DrPacemaker/Voron-Laser-Mod/STLs/laser_pcb_mount.stl

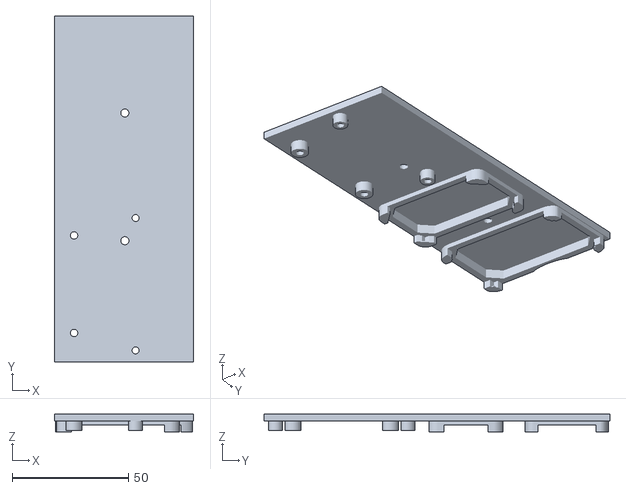
[picture p12: CAD file, 2022-12-12]
STLs/laser_pcb_mount.stl
60.0 x 149.0 x 7.72
