DrPacemaker/Voron-Laser-Mod/STLs/laser_stealthburner_mount.stl

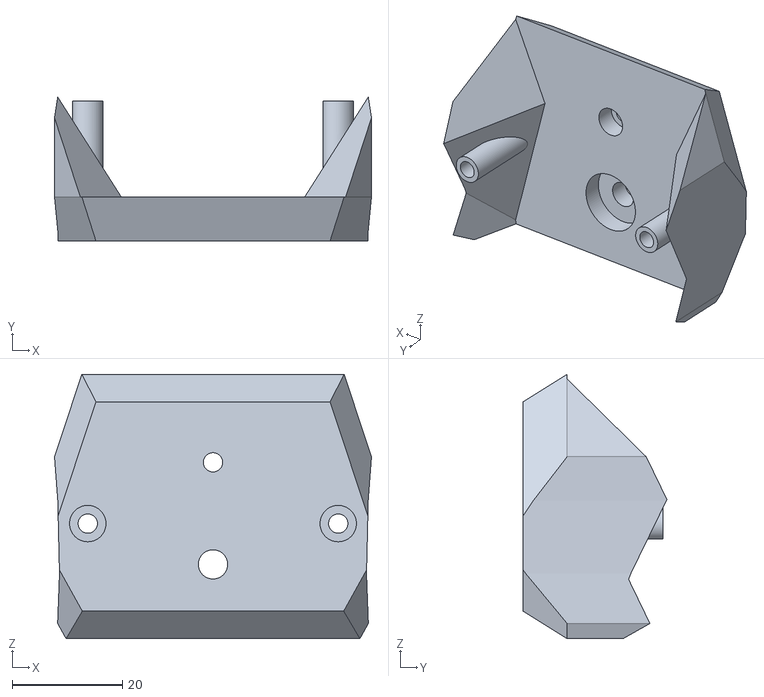
[picture p13: CAD file, 2022-12-12]
STLs/laser_stealthburner_mount.stl
57.5 x 26.1 x 47.9
