DrPacemaker/Voron-Laser-Mod/STLs/laser_air_assist.stl

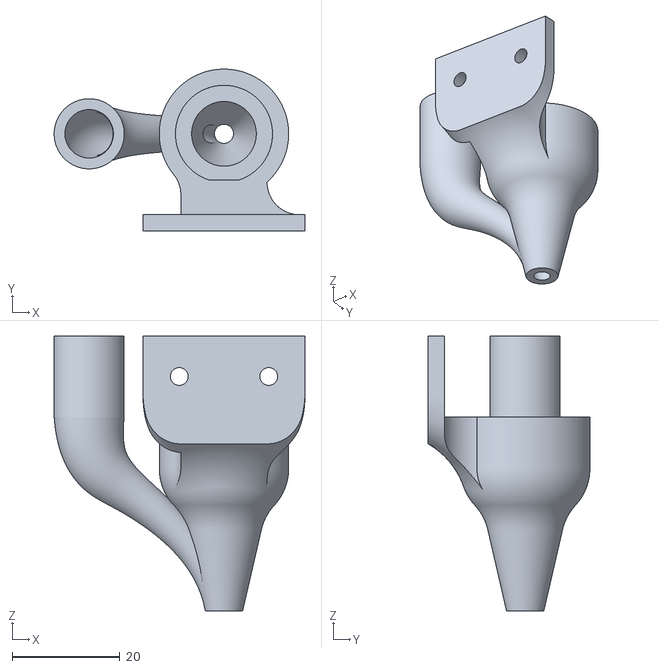
[picture p14: CAD file, 2022-12-12]
STLs/laser_air_assist.stl
46.5 x 30.0 x 51.0
