DrPacemaker/Voron-Laser-Mod/STLs/laser_pcb_bracket.stl

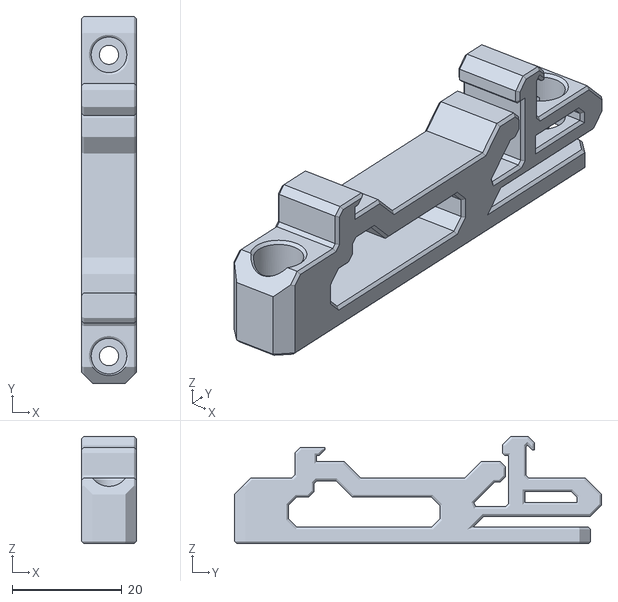
[picture p15: CAD file, 2022-12-12]
STLs/laser_pcb_bracket.stl
10.0 x 67.0 x 19.6
