DrPacemaker/Voron-Laser-Mod/klipper_config/printer.cfg

# This file contains common pin mappings for the BigTreeTech Octopus V1.
# To use this config, the firmware should be compiled for the STM32F446 with a "32KiB bootloader"
# Enable "extra low-level configuration options" and select the "12MHz crystal" as clock reference

# after running "make", copy the generated "klipper/out/klipper.bin" file to a
# file named "firmware.bin" on an SD card and then restart the OctoPus with that SD card.

# See docs/Config_Reference.md for a description of parameters.

## Voron Design VORON2 250/300/350mm BigTreeTech OctoPus V1 TMC2209 UART config

## *** THINGS TO CHANGE/CHECK: ***
## MCU paths                            [mcu] section
## Thermistor types                     [extruder] and [heater_bed] sections - See https://www.klipper3d.org/Config_Reference.html#common-thermistors for common thermistor types
## Z Endstop Switch location            [safe_z_home] section
## Homing end position                  [gcode_macro G32] section
## Z Endstop Switch  offset for Z0      [stepper_z] section
## Probe points                         [quad_gantry_level] section
## Min & Max gantry corner postions     [quad_gantry_level] section
## PID tune                             [extruder] and [heater_bed] sections
## Probe pin                            [probe] section
## Fine tune E steps                    [extruder] section

## Includes
[include ./fluidd.cfg] 
[include ./klicky-probe.cfg] 
[include ./nozzle_scrub.cfg] 
[include ./z_calibration.cfg]    
[include ./laser_boundaries.cfg]    
[include ./chamber_leds.cfg]        
[include ./stealthburner_leds.cfg]  
[include ./runout.cfg] 

[mcu]
##  Obtain definition by "ls -l /dev/serial/by-id/" then unplug to verify
##--------------------------------------------------------------------
serial: /dev/serial/by-id/usb-Klipper_stm32f446xx_130008000250534E4E303720-if00
restart_method: command
##--------------------------------------------------------------------

[printer]
kinematics: corexy
max_velocity: 300  
max_accel: 3000             #Max 4000
max_z_velocity: 15          #Max 15 for 12V TMC Drivers, can increase for 24V
max_z_accel: 350
square_corner_velocity: 5.0

#####################################################################
#   X/Y Stepper Settings
#####################################################################

##  B Stepper - Left
##  Connected to MOTOR_0
##  Endstop connected to DIAG_0
[stepper_x]
step_pin: PF13
dir_pin: PF12
enable_pin: !PF14
rotation_distance: 40
microsteps: 16
full_steps_per_rotation: 200  #set to 400 for 0.9 degree stepper
endstop_pin: PG6
position_min: 0
##--------------------------------------------------------------------

##  Uncomment below for 250mm build
#position_endstop: 250
#position_max: 250

##  Uncomment for 300mm build
#position_endstop: 300
#position_max: 300

##  Uncomment for 350mm build
position_endstop: 350
position_max: 350

##--------------------------------------------------------------------
homing_speed: 75   #Max 100
homing_retract_dist: 5
homing_positive_dir: true

##  Make sure to update below for your relevant driver (2208 or 2209)
[tmc2209 stepper_x]
uart_pin: PC4
interpolate: true
run_current: 0.8
sense_resistor: 0.110
stealthchop_threshold: 0

##  A Stepper - Right
##  Connected to MOTOR_1
##  Endstop connected to DIAG_1
[stepper_y]
step_pin: PG0
dir_pin: PG1
enable_pin: !PF15
rotation_distance: 40
microsteps: 16
full_steps_per_rotation:200  #set to 400 for 0.9 degree stepper
endstop_pin: PG9
position_min: 0
##--------------------------------------------------------------------

##  Uncomment for 250mm build
#position_endstop: 250
#position_max: 250

##  Uncomment for 300mm build
#position_endstop: 300
#position_max: 300

##  Uncomment for 350mm build
position_endstop: 350
position_max: 350

##--------------------------------------------------------------------
homing_speed: 75  #Max 100
homing_retract_dist: 5
homing_positive_dir: true

##  Make sure to update below for your relevant driver (2208 or 2209)
[tmc2209 stepper_y]
uart_pin: PD11
interpolate: true
run_current: 0.8
sense_resistor: 0.110
stealthchop_threshold: 0
 
#####################################################################
#   Z Stepper Settings
#####################################################################

## Z0 Stepper - Front Left
##  Connected to MOTOR_2
##  Endstop connected to DIAG_2
[stepper_z]
step_pin: PF11
dir_pin: PG3
enable_pin: !PG5
rotation_distance: 40
gear_ratio: 80:16
microsteps: 16
endstop_pin: PG10
##  Z-position of nozzle (in mm) to z-endstop trigger point relative to print surface (Z0)
##  (+) value = endstop above Z0, (-) value = endstop below
##  Increasing position_endstop brings nozzle closer to the bed
##  After you run Z_ENDSTOP_CALIBRATE, position_endstop will be stored at the very end of your config
#position_endstop: -0.5
##--------------------------------------------------------------------

position_max: 330

##--------------------------------------------------------------------
position_min: -5
homing_speed: 10
second_homing_speed: 3
homing_retract_dist: 3

##  Make sure to update below for your relevant driver (2208 or 2209)
[tmc2209 stepper_z]
uart_pin: PC6
interpolate: false
run_current: 0.50
sense_resistor: 0.110
#stealthchop_threshold: 0

##  Z1 Stepper - Rear Left
##  Connected to MOTOR_3
[stepper_z1]
step_pin: PG4
dir_pin: !PC1
enable_pin: !PA0
rotation_distance: 40
gear_ratio: 80:16
microsteps: 16

##  Make sure to update below for your relevant driver (2208 or 2209)
[tmc2209 stepper_z1]
uart_pin: PC7
interpolate: false
run_current: 0.50
sense_resistor: 0.110
#stealthchop_threshold: 0

##  Z2 Stepper - Rear Right
##  Connected to MOTOR_4
[stepper_z2]
step_pin: PF9
dir_pin: PF10
enable_pin: !PG2
rotation_distance: 40
gear_ratio: 80:16
microsteps: 16

##  Make sure to update below for your relevant driver (2208 or 2209)
[tmc2209 stepper_z2]
uart_pin: PF2
interpolate: false
run_current: 0.50
sense_resistor: 0.110
#stealthchop_threshold: 0

##  Z3 Stepper - Front Right
##  Connected to MOTOR_5
[stepper_z3]
step_pin: PC13
dir_pin: !PF0
enable_pin: !PF1
rotation_distance: 40
gear_ratio: 80:16
microsteps: 16

##  Make sure to update below for your relevant driver (2208 or 2209)
[tmc2209 stepper_z3]
uart_pin: PE4
interpolate: false
run_current: 0.50
sense_resistor: 0.110
#stealthchop_threshold: 0


#####################################################################
#   Extruder
#####################################################################

##  Connected to MOTOR_6
##  Heater - HE0
##  Thermistor - T0
[extruder]
step_pin: PE2
dir_pin: PE3
enable_pin: !PD4
##  Update value below when you perform extruder calibration
##  If you ask for 100mm of filament, but in reality it is 98mm:
##  rotation_distance = <previous_rotation_distance> * <actual_extrude_distance> / 100
##  22.6789511 is a good starting point
#rotation_distance: 22.6789511   #Bondtech 5mm Drive Gears
rotation_distance: 22.12
##  Update Gear Ratio depending on your Extruder Type
##  Use 50:17 for Afterburner/Clockwork (BMG Gear Ratio)
##  Use 80:20 for M4, M3.1
gear_ratio: 50:10              #BMG Gear Ratio
microsteps: 16
full_steps_per_rotation: 400    #200 for 1.8 degree, 400 for 0.9 degree
nozzle_diameter: 0.400
filament_diameter: 1.75
heater_pin: PA2
## Check what thermistor type you have. See https://www.klipper3d.org/Config_Reference.html#common-thermistors for common thermistor types.
## Use "Generic 3950" for NTC 100k 3950 thermistors
sensor_type: PT1000
sensor_pin: PF4
pullup_resistor: 4700
min_temp: 10
max_temp: 450
#min_temp: -273.15
#max_temp: 9999999
max_power: 1.0
min_extrude_temp: 170
#control = pid
#pid_kp = 26.213
#pid_ki = 1.304
#pid_kd = 131.721
##  Try to keep pressure_advance below 1.0
pressure_advance: 0.074
##  Default is 0.040, leave stock
#pressure_advance_smooth_time: 0.040

##  E0 on MOTOR6
##  Make sure to update below for your relevant driver (2208 or 2209)
[tmc2209 extruder]
uart_pin: PE1
interpolate: false
run_current: 0.5
hold_current: 0.3
sense_resistor: 0.110


#####################################################################
#   Bed Heater
#####################################################################

[heater_bed]
##  SSR Pin - HE1
##  Thermistor - TB
##  Uncomment the following line if using the default SSR wiring from the docs site
heater_pin: PA3
##  Other wiring guides may use BED_OUT to control the SSR. Uncomment the following line for those cases
#heater_pin: PA1
## Check what thermistor type you have. See https://www.klipper3d.org/Config_Reference.html#common-thermistors for common thermistor types.
## Use "Generic 3950" for Keenovo heaters
sensor_type: Generic 3950
sensor_pin: PF3
##  Adjust Max Power so your heater doesn't warp your bed. Rule of thumb is 0.4 watts / cm^2 .
max_power: 0.6
min_temp: 0
#min_temp: -273.15
max_temp: 120
#max_temp: 99999999999
#control: pid
#pid_kp: 58.437
#pid_ki: 2.347
#pid_kd: 363.769

#####################################################################
#   Probe
#####################################################################

[probe]
pin: PG15
x_offset: 0
y_offset: 25.0
#z_offset: 0
speed: 10.0
samples: 3
samples_result: median
sample_retract_dist: 3.0
samples_tolerance: 0.006
samples_tolerance_retries: 5

#####################################################################
#   Fan Control
#####################################################################

[fan]
##  Print Cooling Fan - FAN0
pin: PA8
kick_start_time: 0.5
##  Depending on your fan, you may need to increase this value
##  if your fan will not start. Can change cycle_time (increase)
##  if your fan is not able to slow down effectively
off_below: 0.10

[heater_fan hotend_fan]
##  Hotend Fan - FAN1
pin: PE5
max_power: 1.0
kick_start_time: 0.5
heater: extruder
heater_temp: 50.0
##  If you are experiencing back flow, you can reduce fan_speed
#fan_speed: 1.0

[temperature_sensor chamber]
sensor_type: Generic 3950
sensor_pin: PF5
min_temp: 0
max_temp: 100
gcode_id: C

##  Chamber_fan
[heater_laser_fan chamber_fan]
pin: PD14
max_power: 1.0
fan_speed: 1.0
kick_start_time: 0.5
heater: heater_bed
heater_temp: 40
laser_switch_config_name: output_pin laser_switch_pin

[multi_pin controller_fan_pins]
pins: PD12, PD13

##  Controller fan - FAN2 & FAN3
[heater_fan controller_fans]
pin: multi_pin: controller_fan_pins
kick_start_time: 0.5
fan_speed: 0.5
hardware_pwm: true
#idle_timeout: 300
#stepper: extruder
heater: heater_bed
heater_temp: 40

#####################################################################
#   LASER Control
#####################################################################

[output_pin laser_switch_pin]
pin: PB4
pwm: false

[output_pin laser_pwm_pin]
pin: !PD15 #TBD
pwm: true
cycle_time: 0.001

[gcode_macro M03]
gcode:
    {% set S = params.S|default(0.0)|float %}
    SET_PIN PIN=laser_pwm_pin VALUE={S / 255.0}

[gcode_macro M04]
gcode:
    {% set S = params.S|default(0.0)|float %}
    SET_PIN PIN=laser_pwm_pin VALUE={S / 255.0}

[gcode_macro M05]
gcode:
    SET_PIN PIN=laser_pwm_pin VALUE=0

[gcode_macro LASER_TEST_MODE]
description: Turn laser test mode on/off
gcode:
    SET_PIN PIN=laser_pwm_pin VALUE={0 if printer['output_pin laser_pwm_pin'].value else 0.01 }

[gcode_macro LASER_SWITCH]
description: Turn laser on/off
gcode:
    SET_PIN PIN=laser_switch_pin VALUE={0 if printer['output_pin laser_switch_pin'].value else 1 }

[gcode_macro LASER_OFF]
description: Turn laser off
gcode:
    SET_PIN PIN=laser_switch_pin VALUE=0

[gcode_macro LASER_BOUNDARY]
description: Checks the boundaries of the object to laser
gcode:
    LASER_BOUNDARIES

#####################################################################
#   Homing and Gantry Adjustment Routines
#####################################################################

[idle_timeout]
timeout: 900
gcode:
    STEALTHBURNER_LOGO_LEDS_OFF
    STEALTHBURNER_NOZZLE_LEDS_OFF
    CHAMBER_LED_OFF
     M84

[bed_mesh]
speed: 300
horizontal_move_z: 10
##--------------------------------------------------------------------
mesh_min: 40, 40
mesh_max: 310,310
##--------------------------------------------------------------------
fade_start: 0.6
fade_end: 10.0
probe_count: 5,5
algorithm: bicubic
relative_reference_index: 12

[quad_gantry_level]
##  Use QUAD_GANTRY_LEVEL to level a gantry.
##  Min & Max gantry corners - measure from nozzle at MIN (0,0) and 
##  MAX (250, 250), (300,300), or (350,350) depending on your printer size
##  to respective belt positions

#--------------------------------------------------------------------

##  Gantry Corners for 350mm Build
##  Uncomment for 350mm build
gantry_corners:
   -60,-10
   410,420
##  Probe points
points:
   50,25
   50,275
   300,275
   300,25

#--------------------------------------------------------------------
speed: 100
horizontal_move_z: 10
retries: 5
retry_tolerance: 0.0075
max_adjust: 10

#--------------------------------------------------------------------


#####################################################################
#   Macros
#####################################################################
[gcode_macro CHAMBER_LED_ON]
description: Turn leds on
gcode:
    SET_LED LED=chamber_leds RED=0.5 GREEN=0.5 BLUE=1

[gcode_macro CHAMBER_LED_OFF]
description: Turn leds off
gcode:
    SET_LED LED=chamber_leds RED=0 GREEN=0 BLUE=0

[gcode_macro AutoCalibrateZ]
description: Docks Klicky Probe
gcode:
    stealthburner_status_calibrating_z
    chamber_status_calibrating_z
    CALIBRATE_Z
    stealthburner_status_ready
    chamber_status_ready

[gcode_macro G32]
gcode:
    stealthburner_status_homing
    chamber_status_homing
    SAVE_GCODE_STATE NAME=STATE_G32
    G90
    G28
    stealthburner_status_leveling
    chamber_status_leveling
    QUAD_GANTRY_LEVEL
    stealthburner_status_homing
    chamber_status_homing
    G28
    G0 X175 Y175 Z30 F3600
    RESTORE_GCODE_STATE NAME=STATE_G32
    stealthburner_status_ready
    chamber_status_ready
   
[gcode_macro PRINT_START]
#   Use PRINT_START for the slicer starting script - please customise for your slicer of choice
gcode:
    G32                            ; home all axes
    G90                            ; absolute positioning
    G1 Z20 F3000                   ; move nozzle away from bed
    CLEAN_NOZZLE                   ; clean nozzle with brush
    CALIBRATE_Z                    ; calibrate z offset
	CLEAN_NOZZLE				   
    BED_MESH_CALIBRATE             ; calibrate bed mesh
    stealthburner_status_printing
    chamber_status_printing

[gcode_macro PRINT_END]
#   Use PRINT_END for the slicer ending script - please customise for your slicer of choice
gcode:
    # safe anti-stringing move coords
    {% set th = printer.toolhead %}
    {% set x_safe = th.position.x + 20 * (1 if th.axis_maximum.x - th.position.x > 20 else -1) %}
    {% set y_safe = th.position.y + 20 * (1 if th.axis_maximum.y - th.position.y > 20 else -1) %}
    {% set z_safe = [th.position.z + 2, th.axis_maximum.z]|min %}
    
    SAVE_GCODE_STATE NAME=STATE_PRINT_END
    
    M400                           ; wait for buffer to clear
    G92 E0                         ; zero the extruder
    G1 E-5.0 F1800                 ; retract filament
    
    TURN_OFF_HEATERS
    
    G90                                      ; absolute positioning
    G0 X{x_safe} Y{y_safe} Z{z_safe} F20000  ; move nozzle to remove stringing
    G0 X{th.axis_maximum.x//2} Y{th.axis_maximum.y - 2} F3600  ; park nozzle at rear
    M107                                     ; turn off fan
    
    BED_MESH_CLEAR
    RESTORE_GCODE_STATE NAME=STATE_PRINT_END
    stealthburner_status_ready
    chamber_status_ready

#*# <---------------------- SAVE_CONFIG ---------------------->
#*# DO NOT EDIT THIS BLOCK OR BELOW. The contents are auto-generated.
#*#
#*# [stepper_z]
#*# position_endstop = 1.600
#*#
#*# [heater_bed]
#*# control = pid
#*# pid_kp = 42.963
#*# pid_ki = 0.830
#*# pid_kd = 555.832
#*#
#*# [extruder]
#*# control = pid
#*# pid_kp = 24.114
#*# pid_ki = 1.209
#*# pid_kd = 120.268
#*#
#*# [bed_mesh default]
#*# version = 1
#*# points =
#*# 	  -0.027500, 0.077500, 0.085000, 0.052500, -0.050000
#*# 	  -0.082500, -0.010000, 0.055000, 0.002500, -0.072500
#*# 	  -0.110000, 0.180000, 0.000000, -0.015000, -0.077500
#*# 	  -0.080000, 0.000000, 0.005000, -0.010000, -0.067500
#*# 	  -0.005000, 0.062500, 0.067500, 0.045000, -0.015000
#*# tension = 0.2
#*# min_x = 40.0
#*# algo = bicubic
#*# y_count = 5
#*# mesh_y_pps = 2
#*# min_y = 40.0
#*# x_count = 5
#*# max_y = 310.0
#*# mesh_x_pps = 2
#*# max_x = 310.0
#*#
#*# [probe]
#*# z_offset = 6.455
