DrPacemaker/Voron-Laser-Mod/(commit log)

2022-12-12 initial draft
    [laser_air_assist.stl, laser_pcb_bracket.stl, laser_pcb_mount.stl, laser_stealthburner_mount.stl]
2022-12-12 adding laser warning
2022-12-12 adding custom scripts
    [chamber_leds.cfg, klicky-bed-mesh-calibrate.cfg, klicky-macros.cfg, klicky-probe.cfg, klicky-quad-gantry-level.cfg, klicky-variables.cfg, laser_boundaries.cfg, printer.cfg]
2022-12-12 fixed klipperscreen style
2022-12-13 added KlipperScreen content
    [laser_boundaries.cfg]
2022-12-15 designed laser panel
2022-12-15 Adding laser panel
    [printer.cfg]
2022-12-16 added flowchart
2022-12-19 adding chamber sensor & fixing styles
    [printer.cfg, runout.cfg]
